mhe747/BeagleSDR2/photo/IMG_20190711_085238.jpg

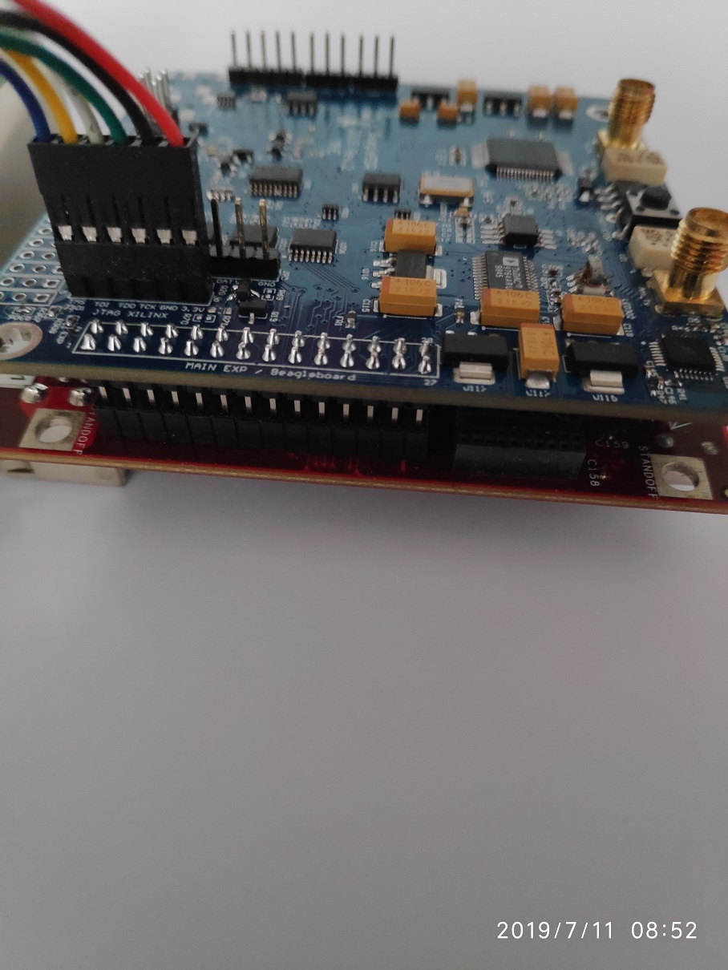
photo/IMG_20190711_085238.jpg
