mhe747/BeagleSDR2/photo/IMG_20190711_085028.jpg

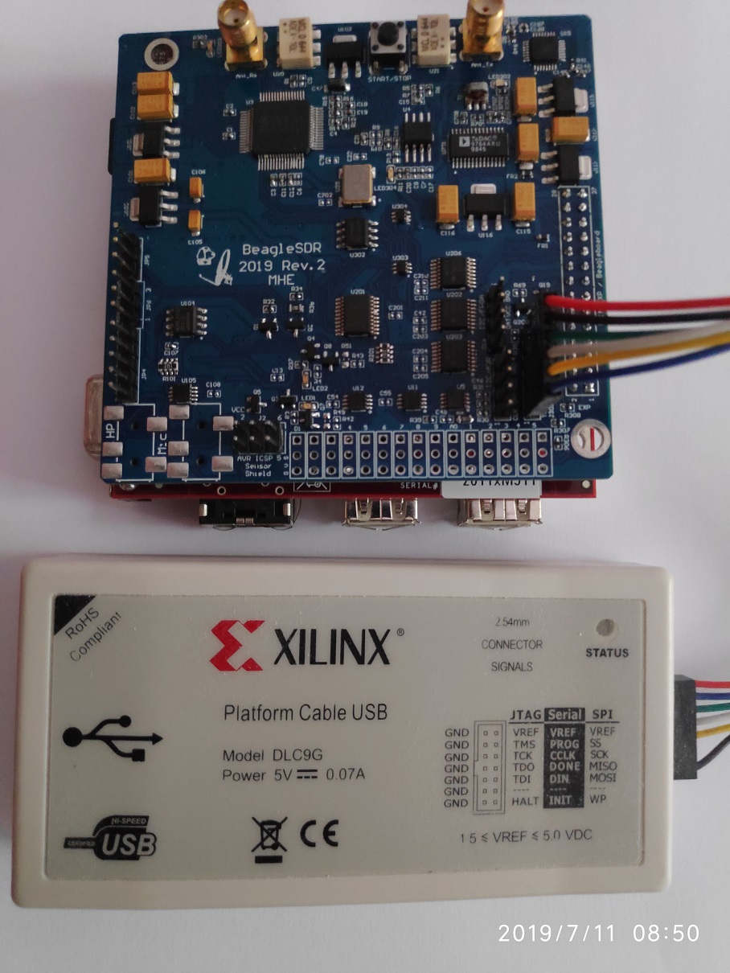
photo/IMG_20190711_085028.jpg
