mhe747/BeagleSDR2/photo/Readme.md

Some photos of the BeagleSDR2, the add-on board for the famous beagleboard-xM
