mhe747/BeagleSDR2/MHE.jpg

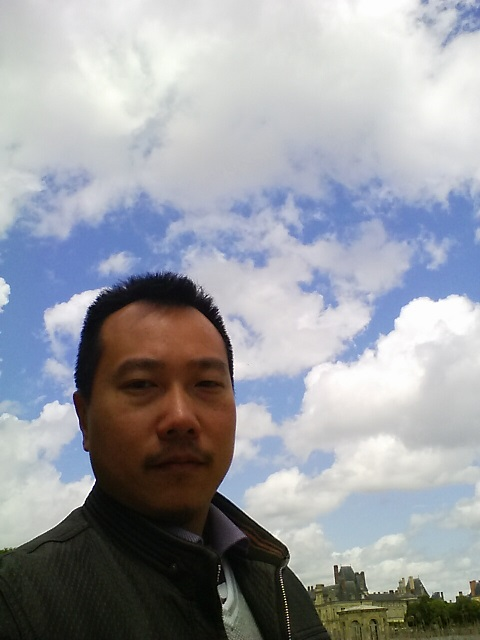
MHE.jpg
