mhe747/BeagleSDR2/photo/IMG_20190711_004727.jpg

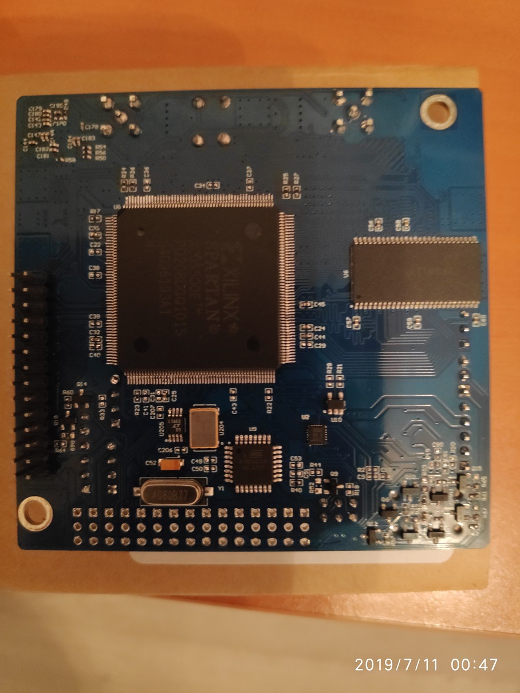
photo/IMG_20190711_004727.jpg
