mhe747/BeagleSDR2/photo/IMG_20190711_090203.jpg

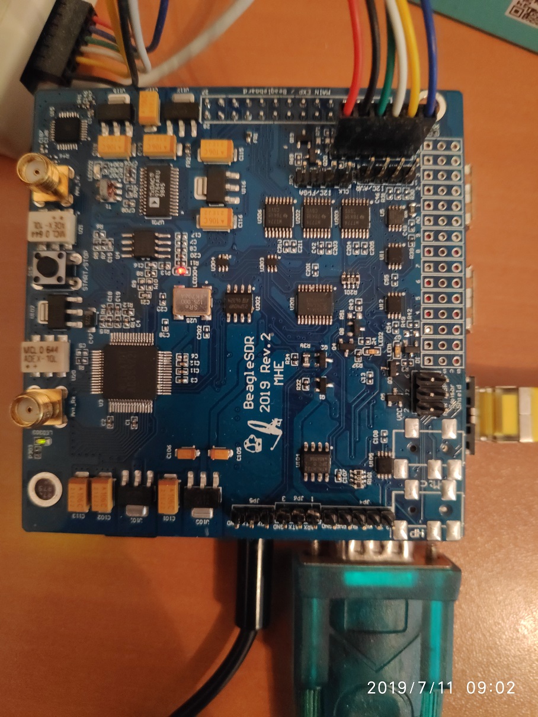
photo/IMG_20190711_090203.jpg
