mhe747/BeagleSDR2/schematics/beagle_sdr2_overlay_bottom.png

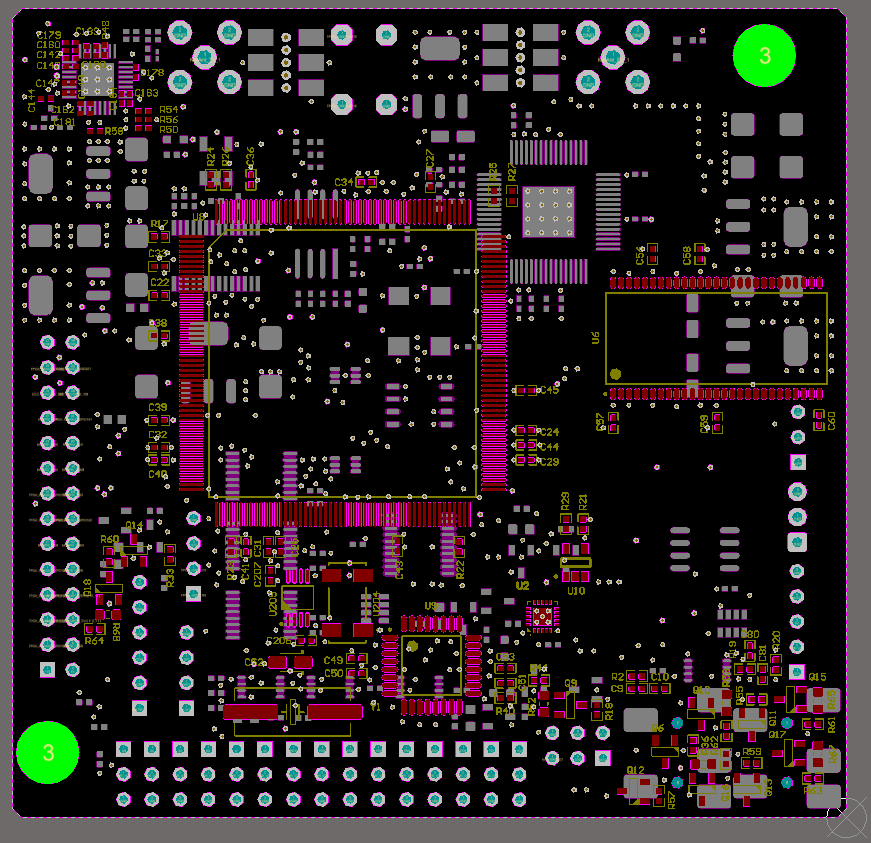
schematics/beagle_sdr2_overlay_bottom.png
