mhe747/BeagleSDR2/schematics/beagle_sdr2_pcb_bottom.png

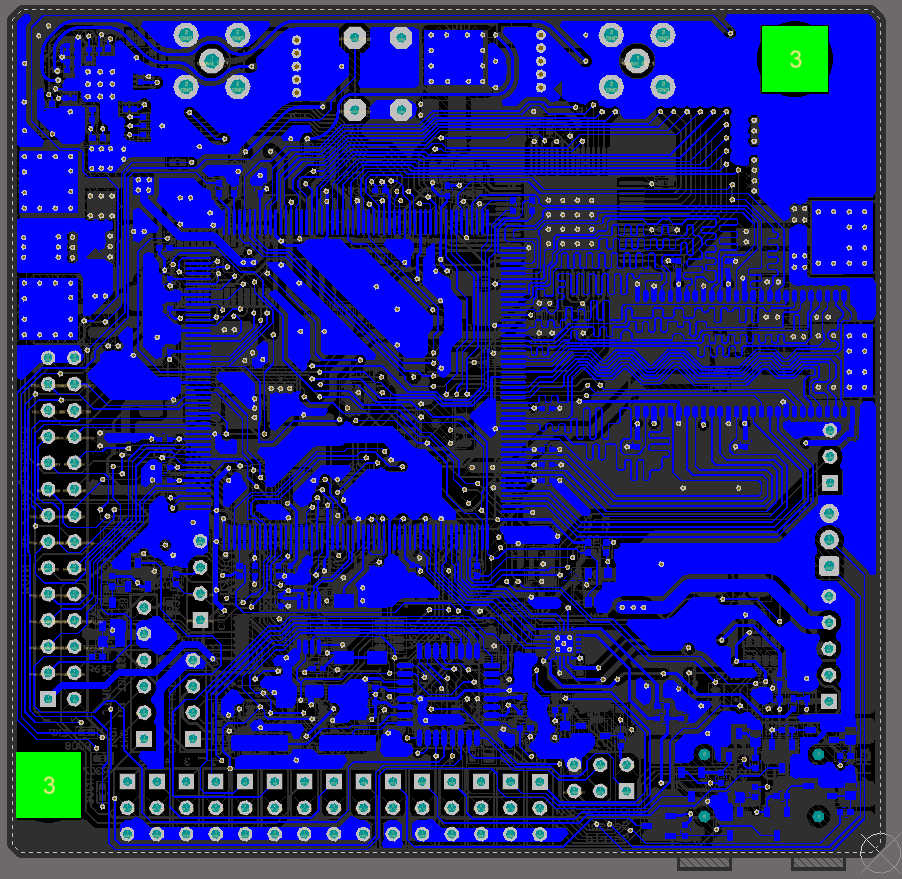
schematics/beagle_sdr2_pcb_bottom.png
