mhe747/BeagleSDR2/schematics/beagle_sdr2_pcb_top.png

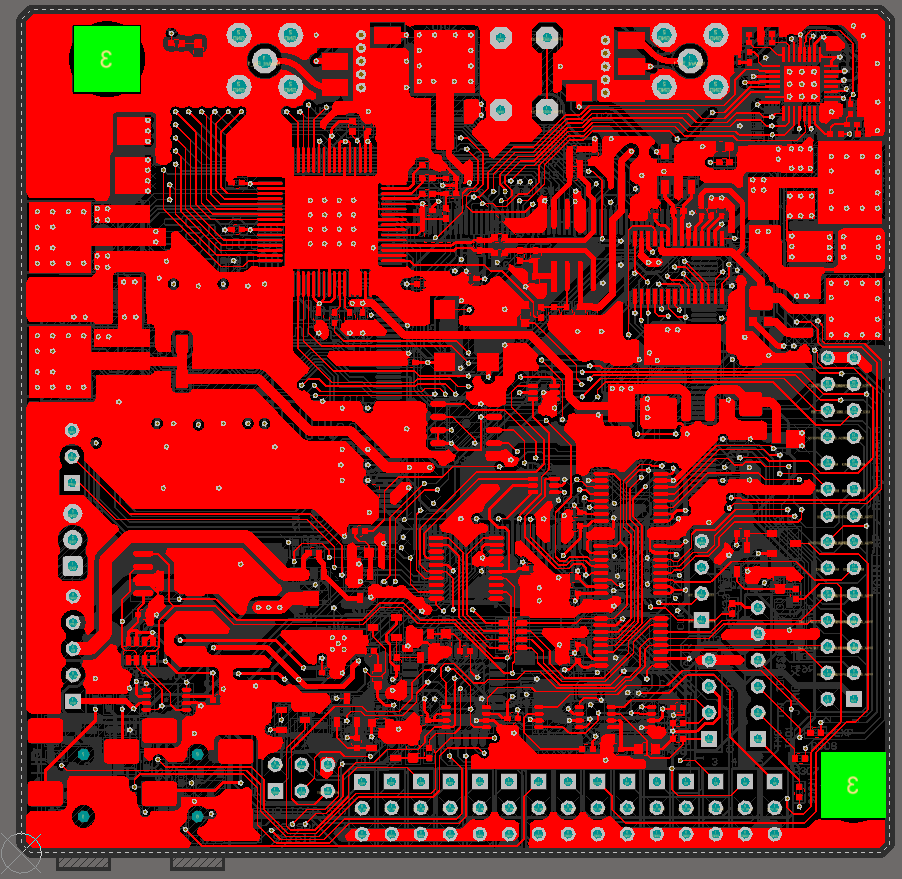
schematics/beagle_sdr2_pcb_top.png
