mhe747/BeagleSDR2/schematics/beagle_sdr2.pdf

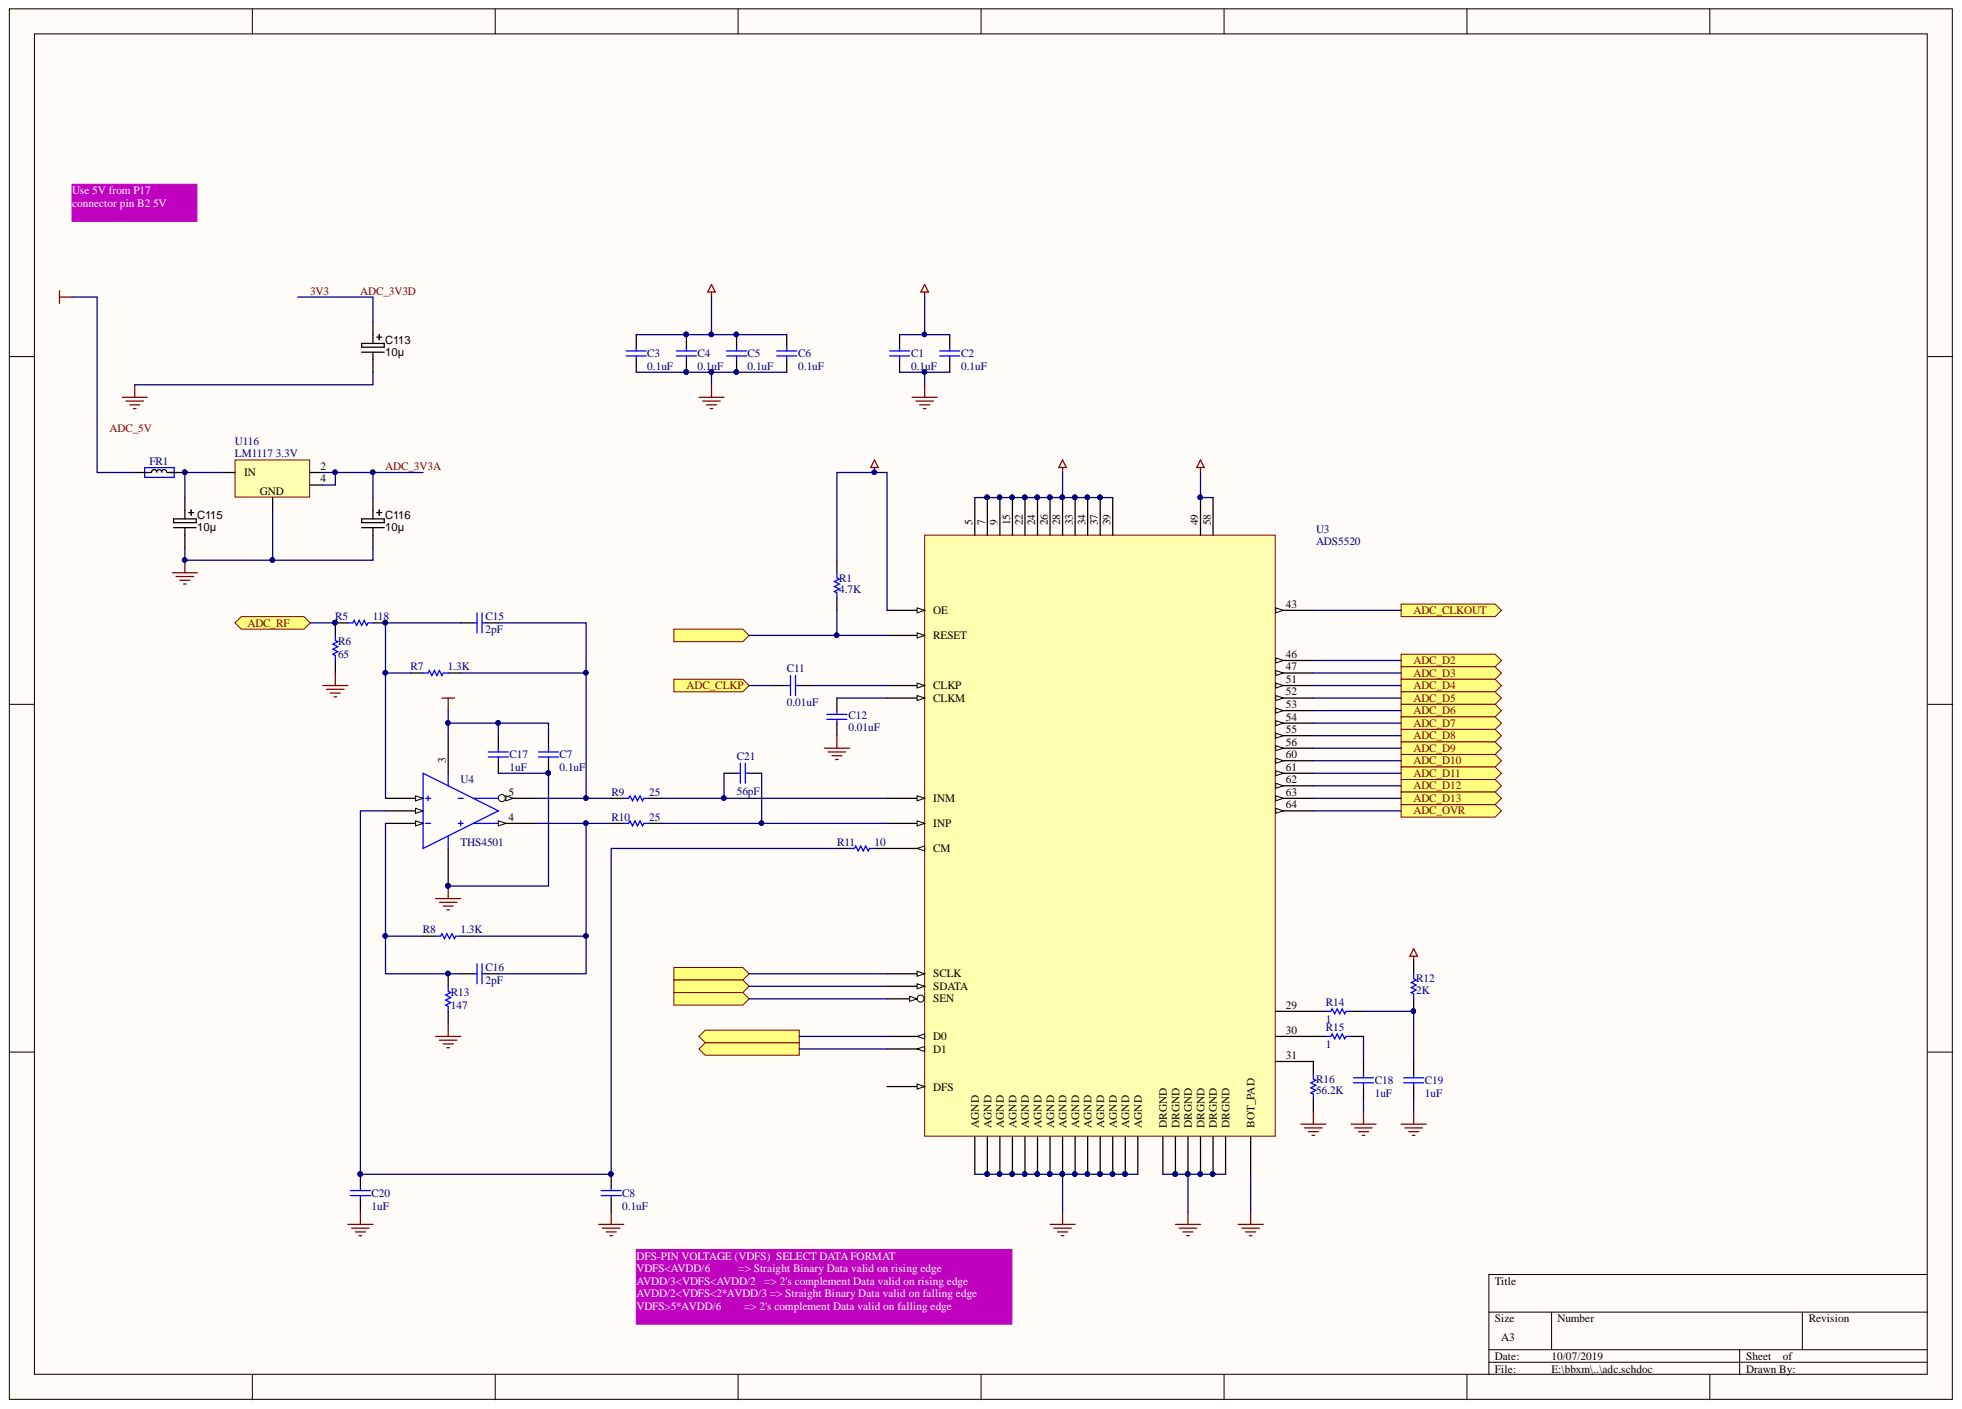
[picture p10: page 1]

THS4501 | 4

DFS-PIN VOLTAGE (VDFS) SELECT DATA FORMAT
AVDD/3<VDFS<AVDD/2 => 2's complement Data valid on rising edge
AVDD/2<VDFS<2*AVDD/3 => Straight Binary Data valid on falling edge

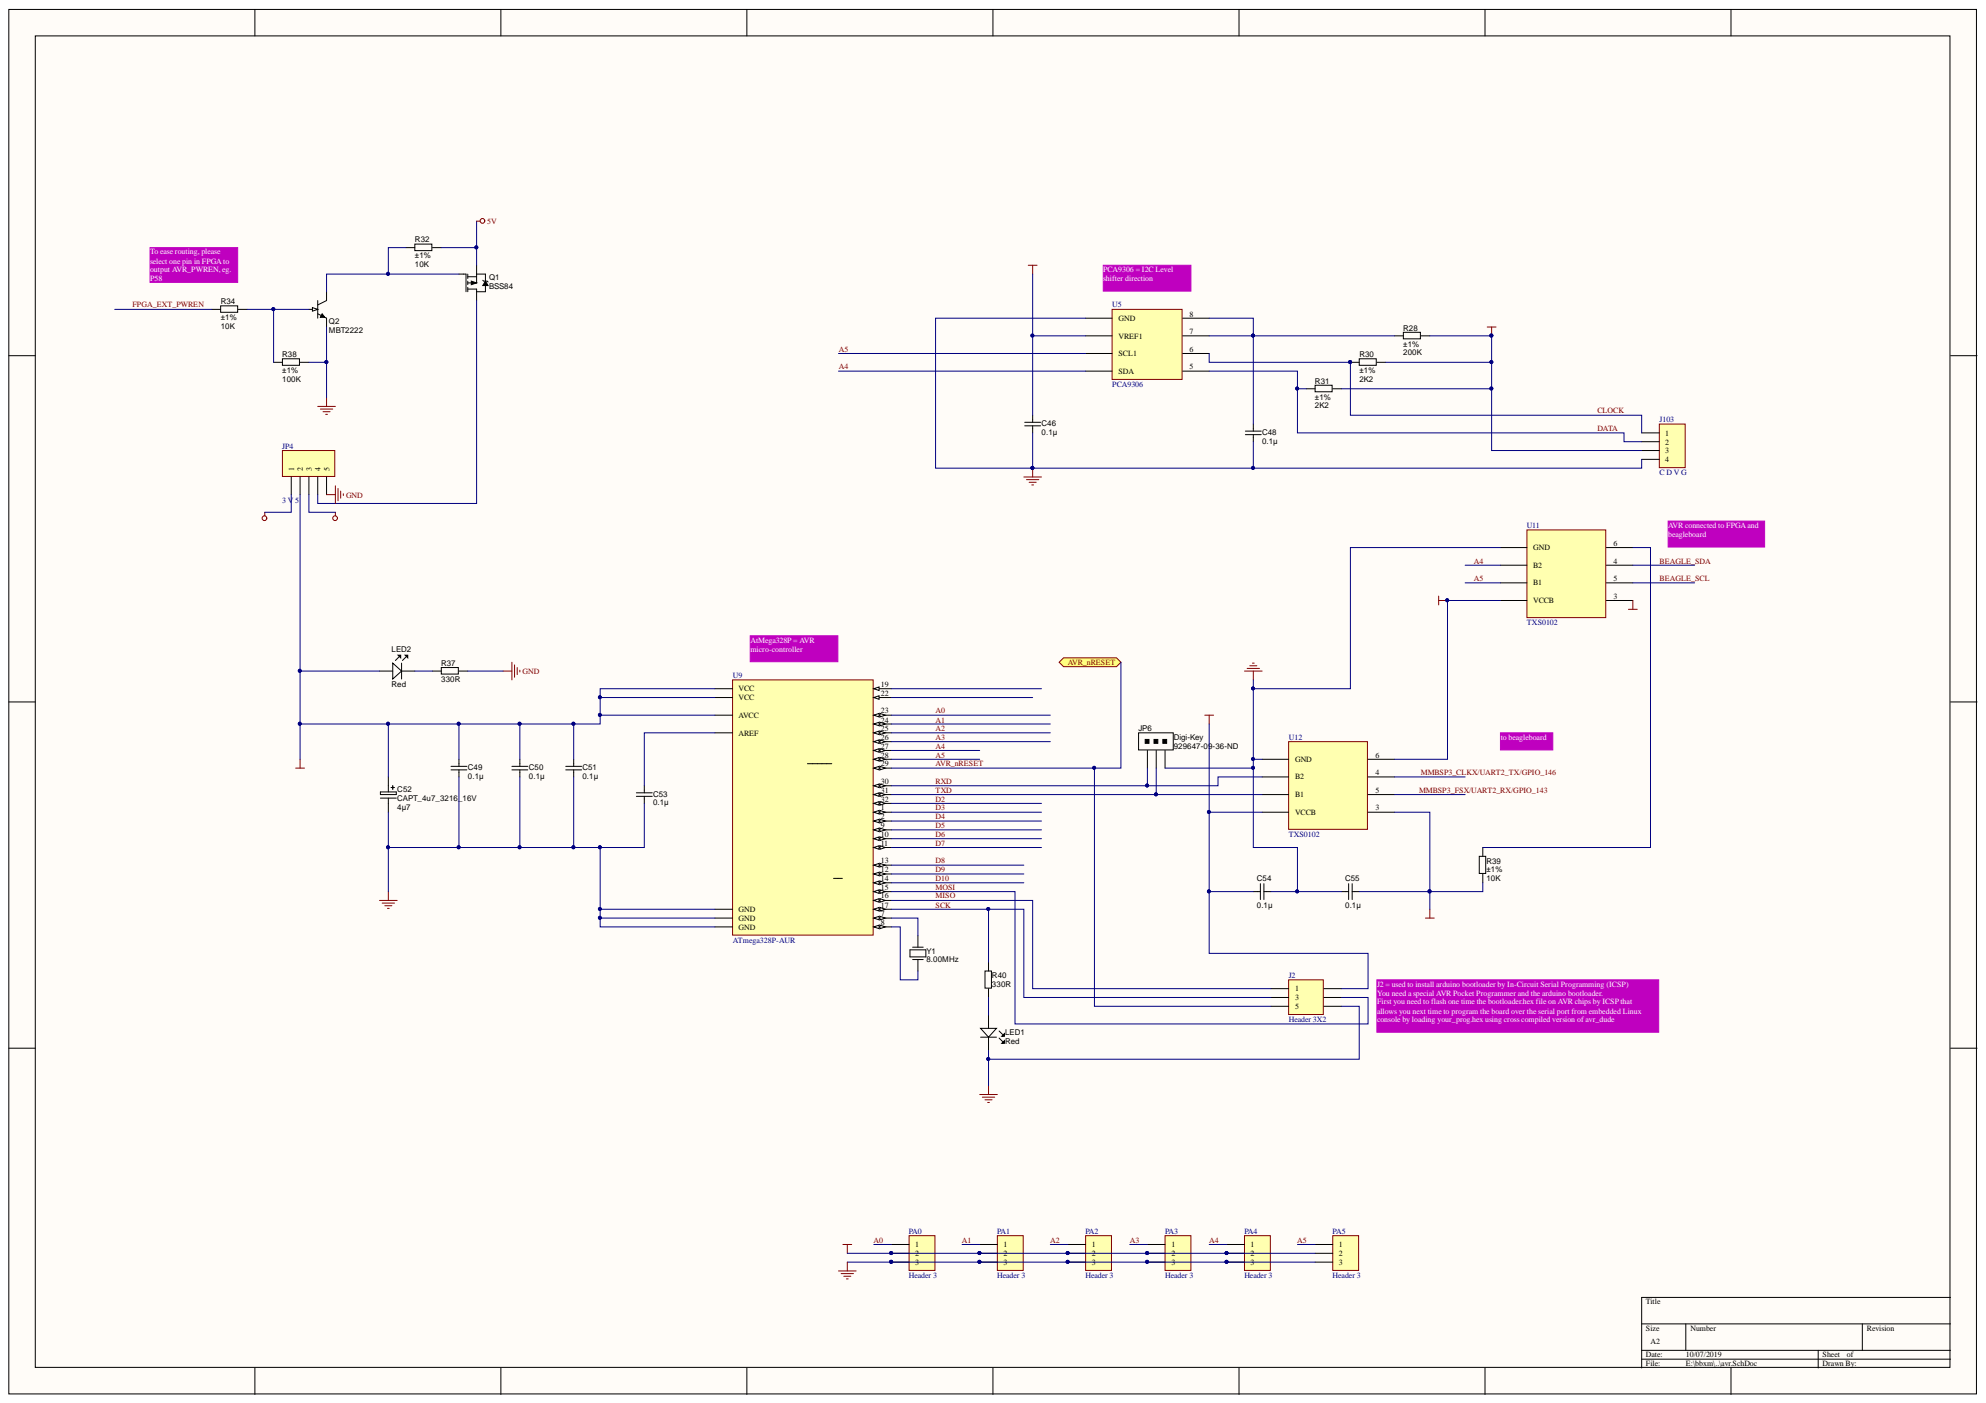
[picture p11: page 2]

To ease routing, please
select one pin in FPGA to
output AVR_PWREN, eg.

AVR connected to FPGA and
beagleboard

SCK | 0.1µ

J2 = used to install arduino bootloader by In-Circuit Serial Programming (ICSP)
You need a special AVR Pocket Programmer and the arduino bootloader.
First you need to flash one time the bootloader.hex file on AVR chips by ICSP that
allows you next time to program the board over the serial port from embedded Linux
console by loading your_prog.hex using cross compiled version of avr_dude

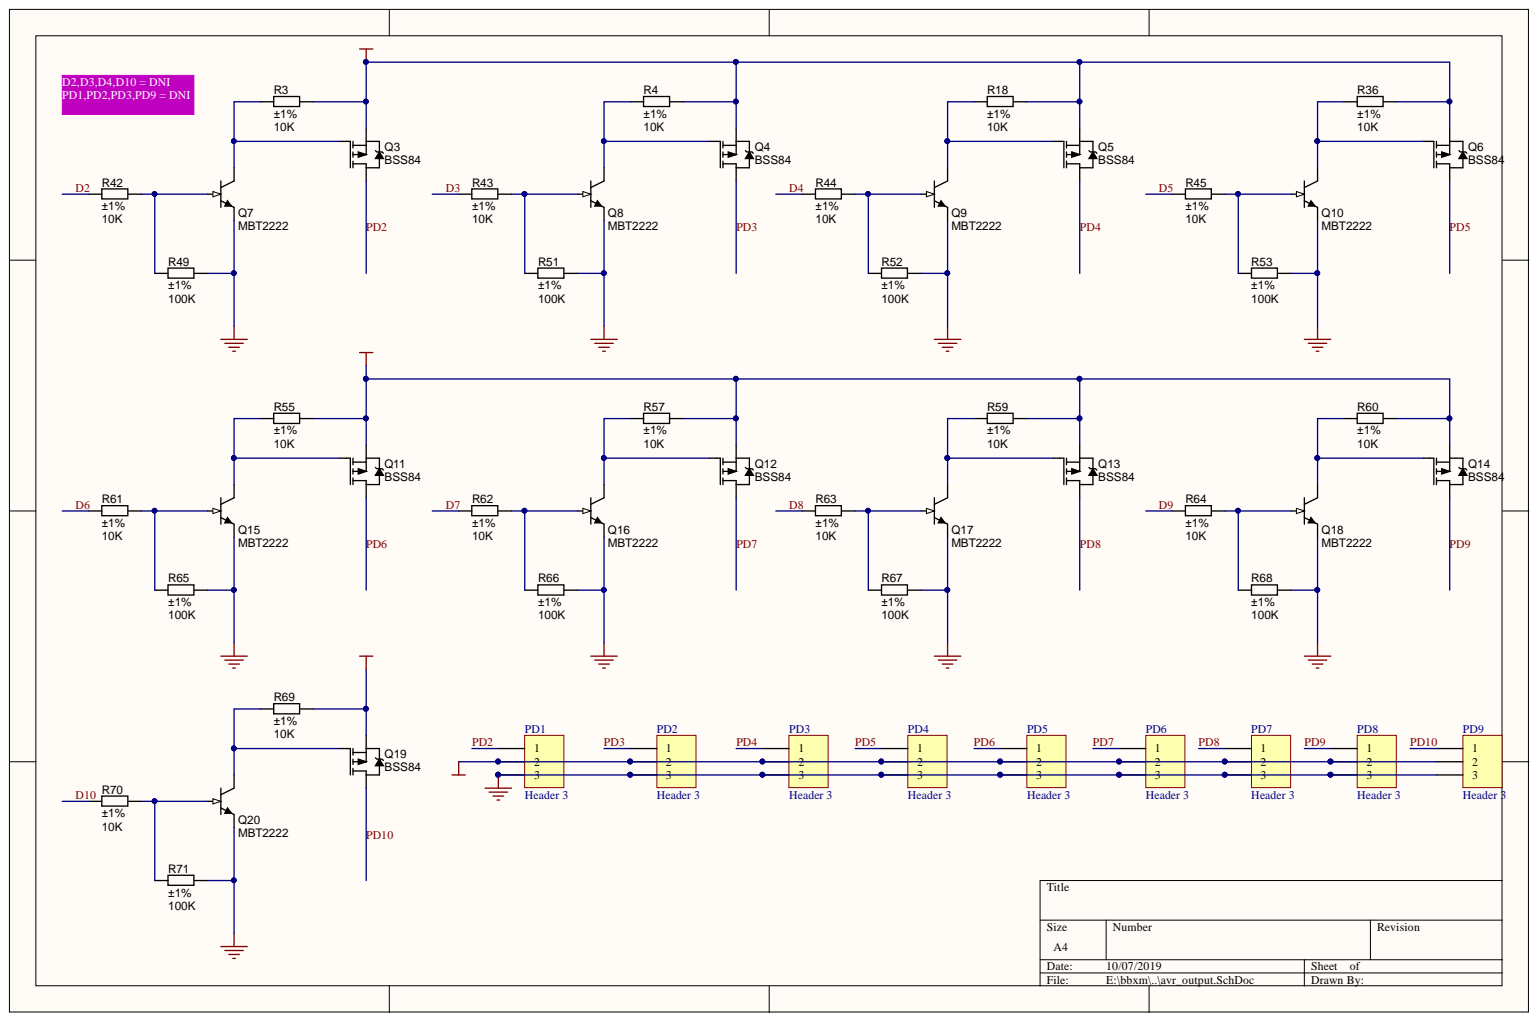
[picture p12: page 3]

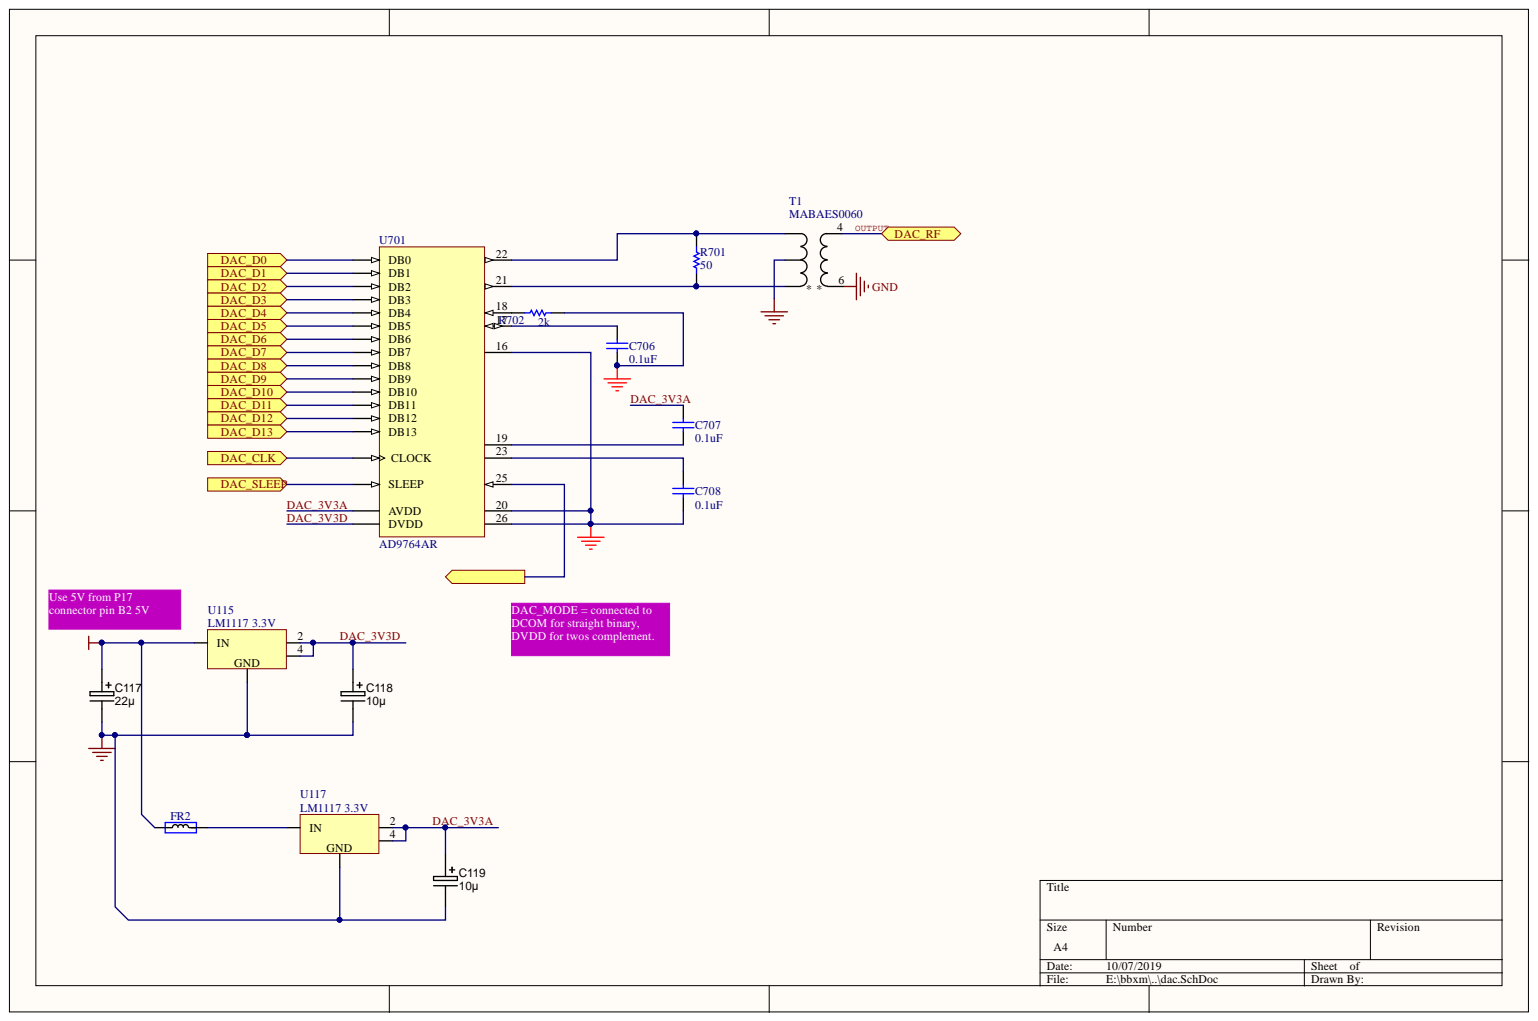
[picture p13: page 4]

DAC_MODE = connected to
DCOM for straight binary,
DVDD for twos complement.

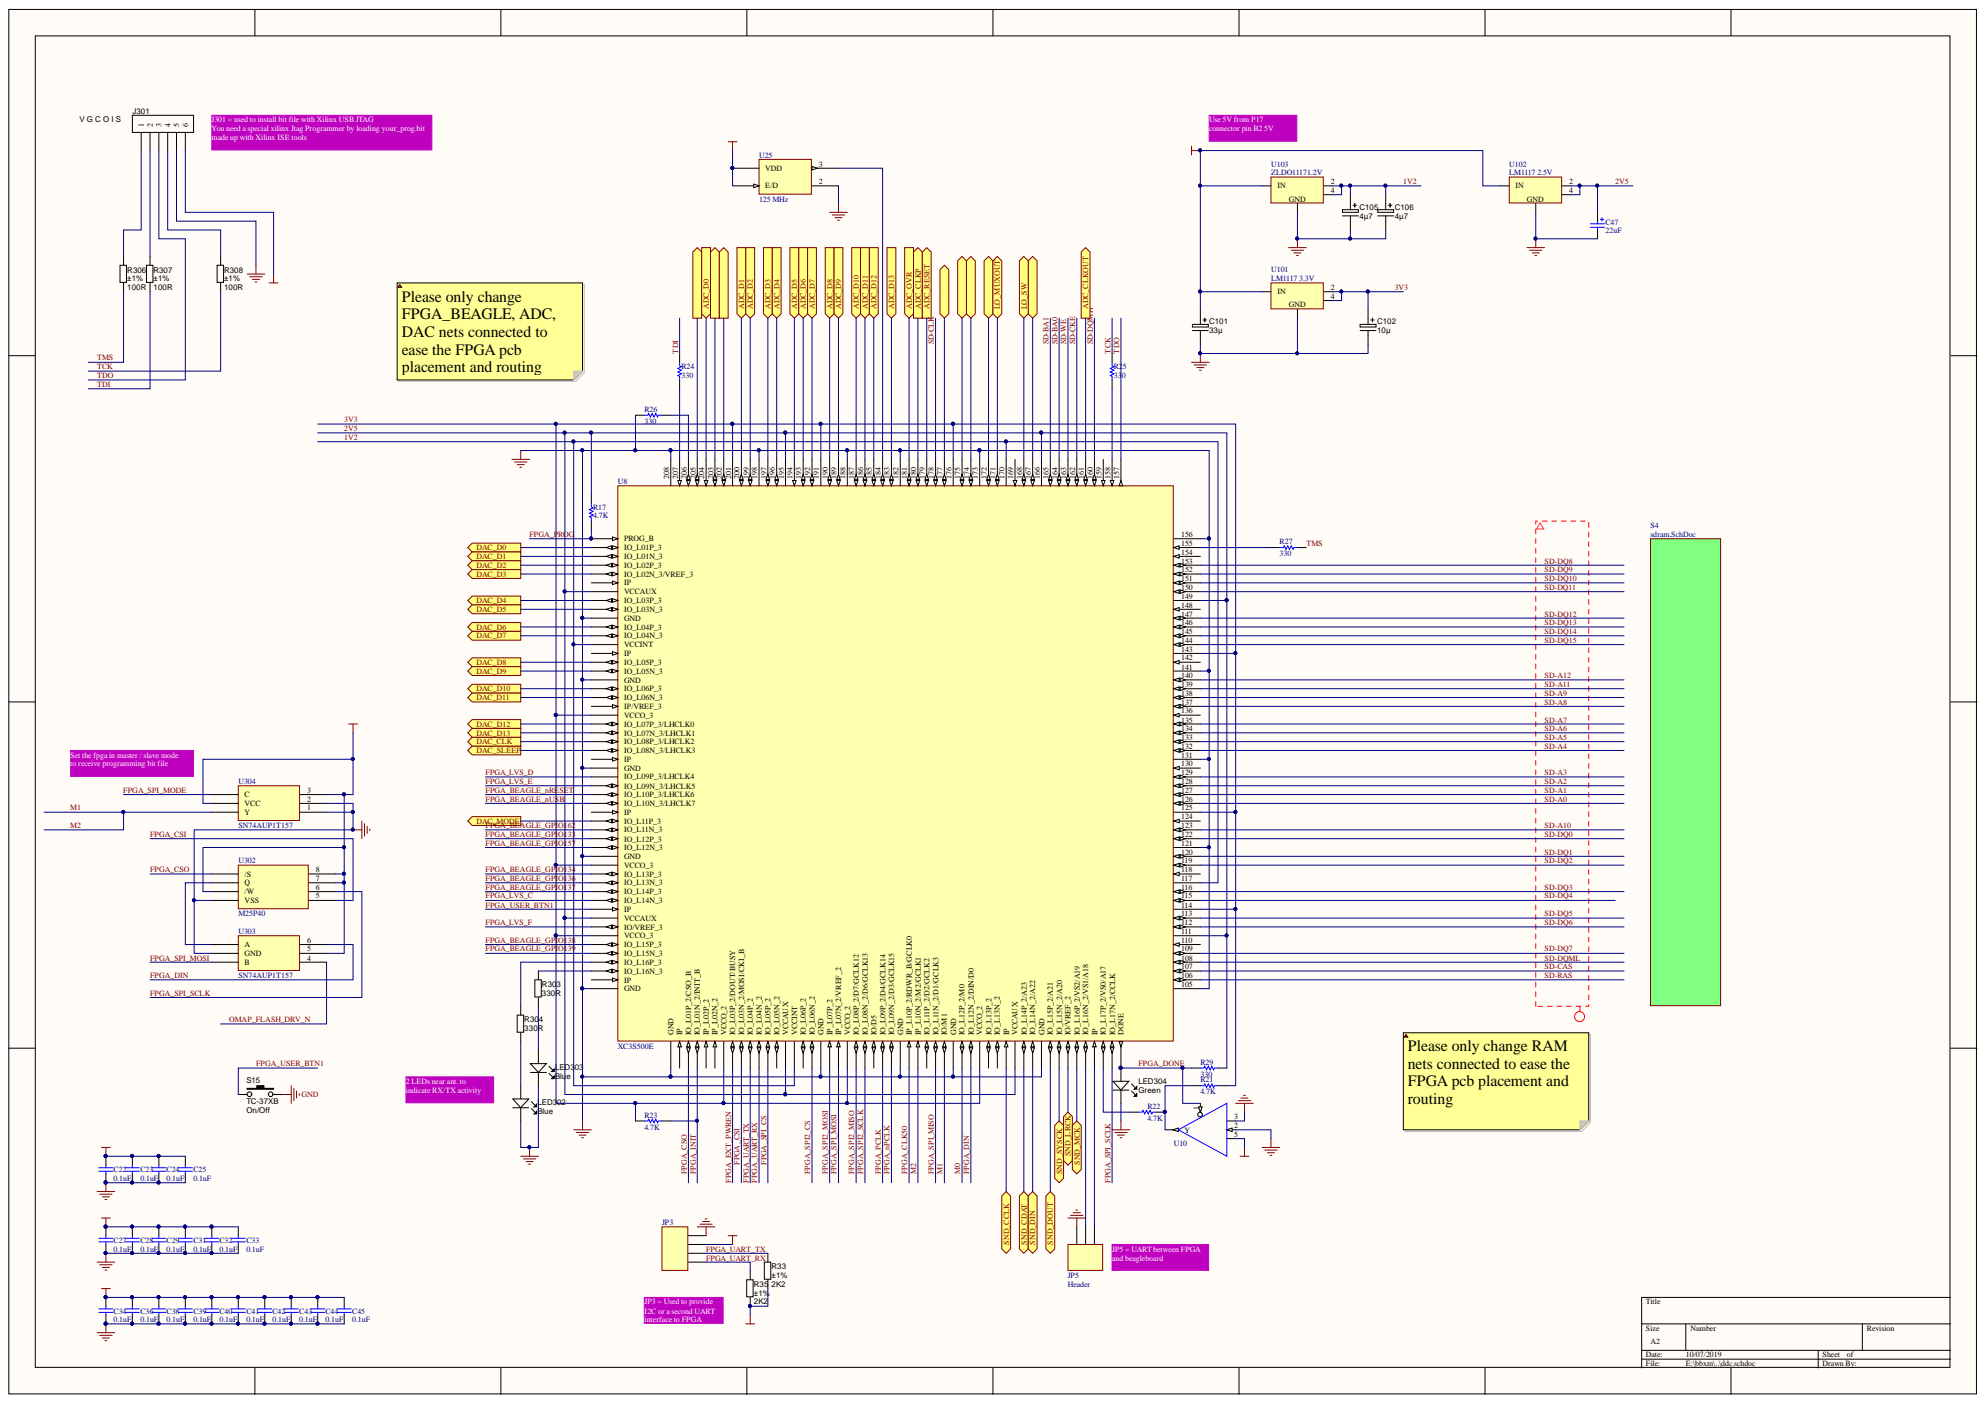
[picture p14: page 5]

J301 = used to install bit file with Xilinx USB JTAG
You need a special xilinx Jtag Programmer by loading your_prog.bit
made up with Xilinx ISE tools

Please only change
FPGA_BEAGLE, ADC,
DAC nets connected to
ease the FPGA pcb
placement and routing

IO_L03P_0 164 IO_L03N_0 165 VCCAUX 166 IO_L04P_0 167 IO_L04N_0/VREF_0 168 IP 169 VCCINT 170 IO_L05P_0 171 IO_L05N_0 172 GND 173 IO_L06P_0 174 IO_L06N_0 175 VCCO_0 176 IO_L07P_0/GCLK4 177 IO_L07N_0/GCLK5 178 IO/VREF_0 179 IO_L08P_0/GCLK6 180 IO_L08N_0/GCLK7 181 GND 182 IO_L09P_0/GCLK8 183 IO_L09N_0/GCLK9 184 IO_L10P_0/GCLK10 185 IO_L10N_0/GCLK11 186 IO 187 GND 188 IO_L11P_0 189 IO_L11N_0 190 VCCO_0 191 IO_L12P_0 192 IO_L12N_0/VREF_0 193 IP 194 VCCAUX 195 IO_L13P_0 196 IO_L13N_1 197 GND 198 IO_L14P_0 199 IO_L14N_0/VREF_0 200 VCCO_0 201 IO_L15P_0 202 IO_L15N_0 203 IP 204 IO_L16P_0 205 IO_L16N_0/HSWAP 206 TDI 207 GND 208

Set the fpga in master / slave mode
to receive programming bit file

FPGA_SPI_MOSI

FPGA_DIN

FPGA_SPI_SCLK

Please only change RAM
nets connected to ease the
FPGA pcb placement and
routing

2 LEDs near ant. to
indicate RX/TX activity

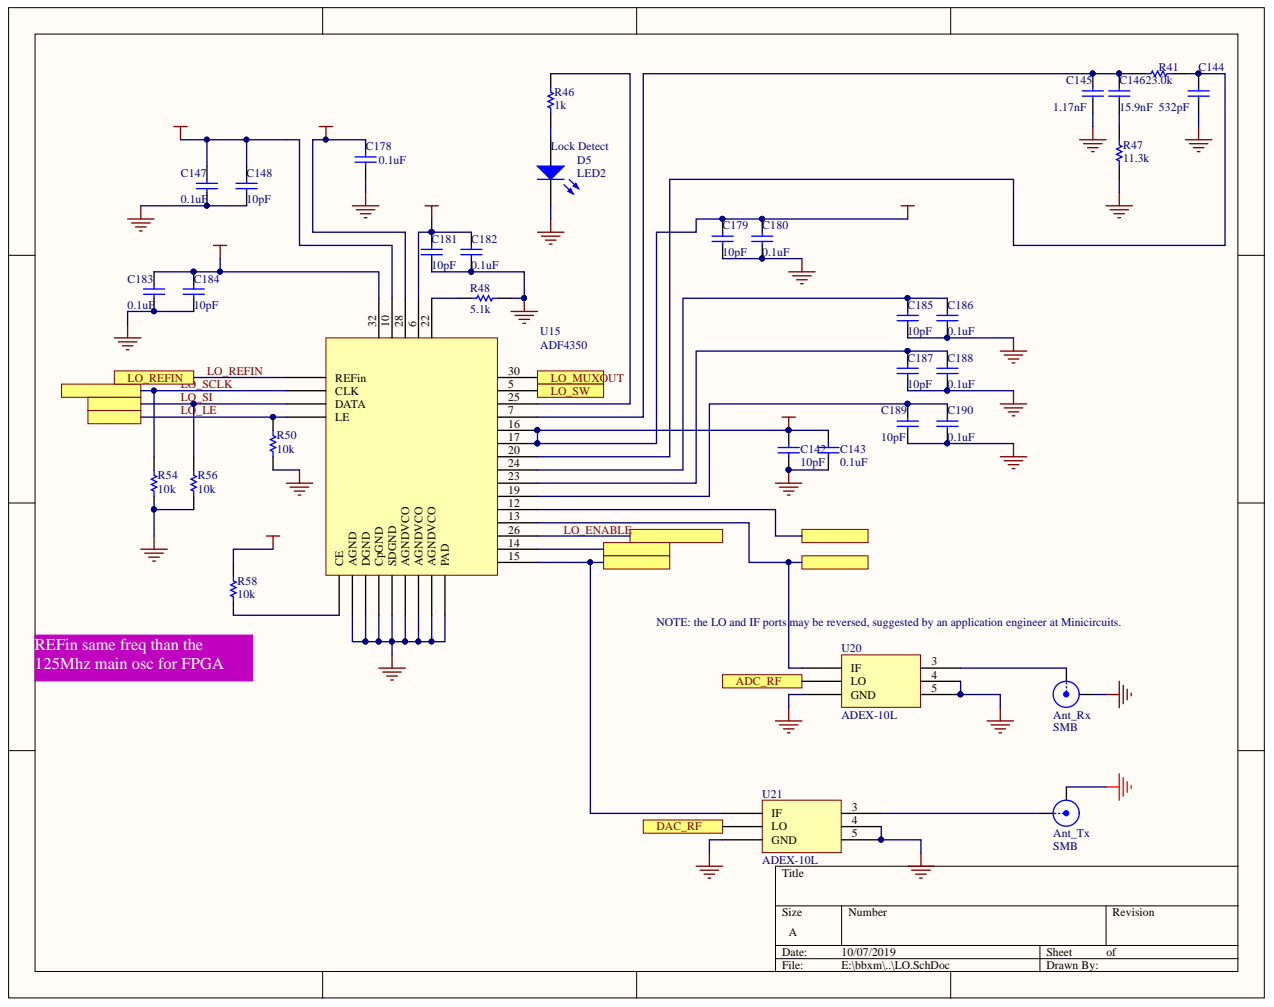
[picture p15: page 6]

U15 ADF4350

NOTE: the LO and IF ports may be reversed, suggested by an application engineer at Minicircuits.

REFin same freq than the
125Mhz main osc for FPGA

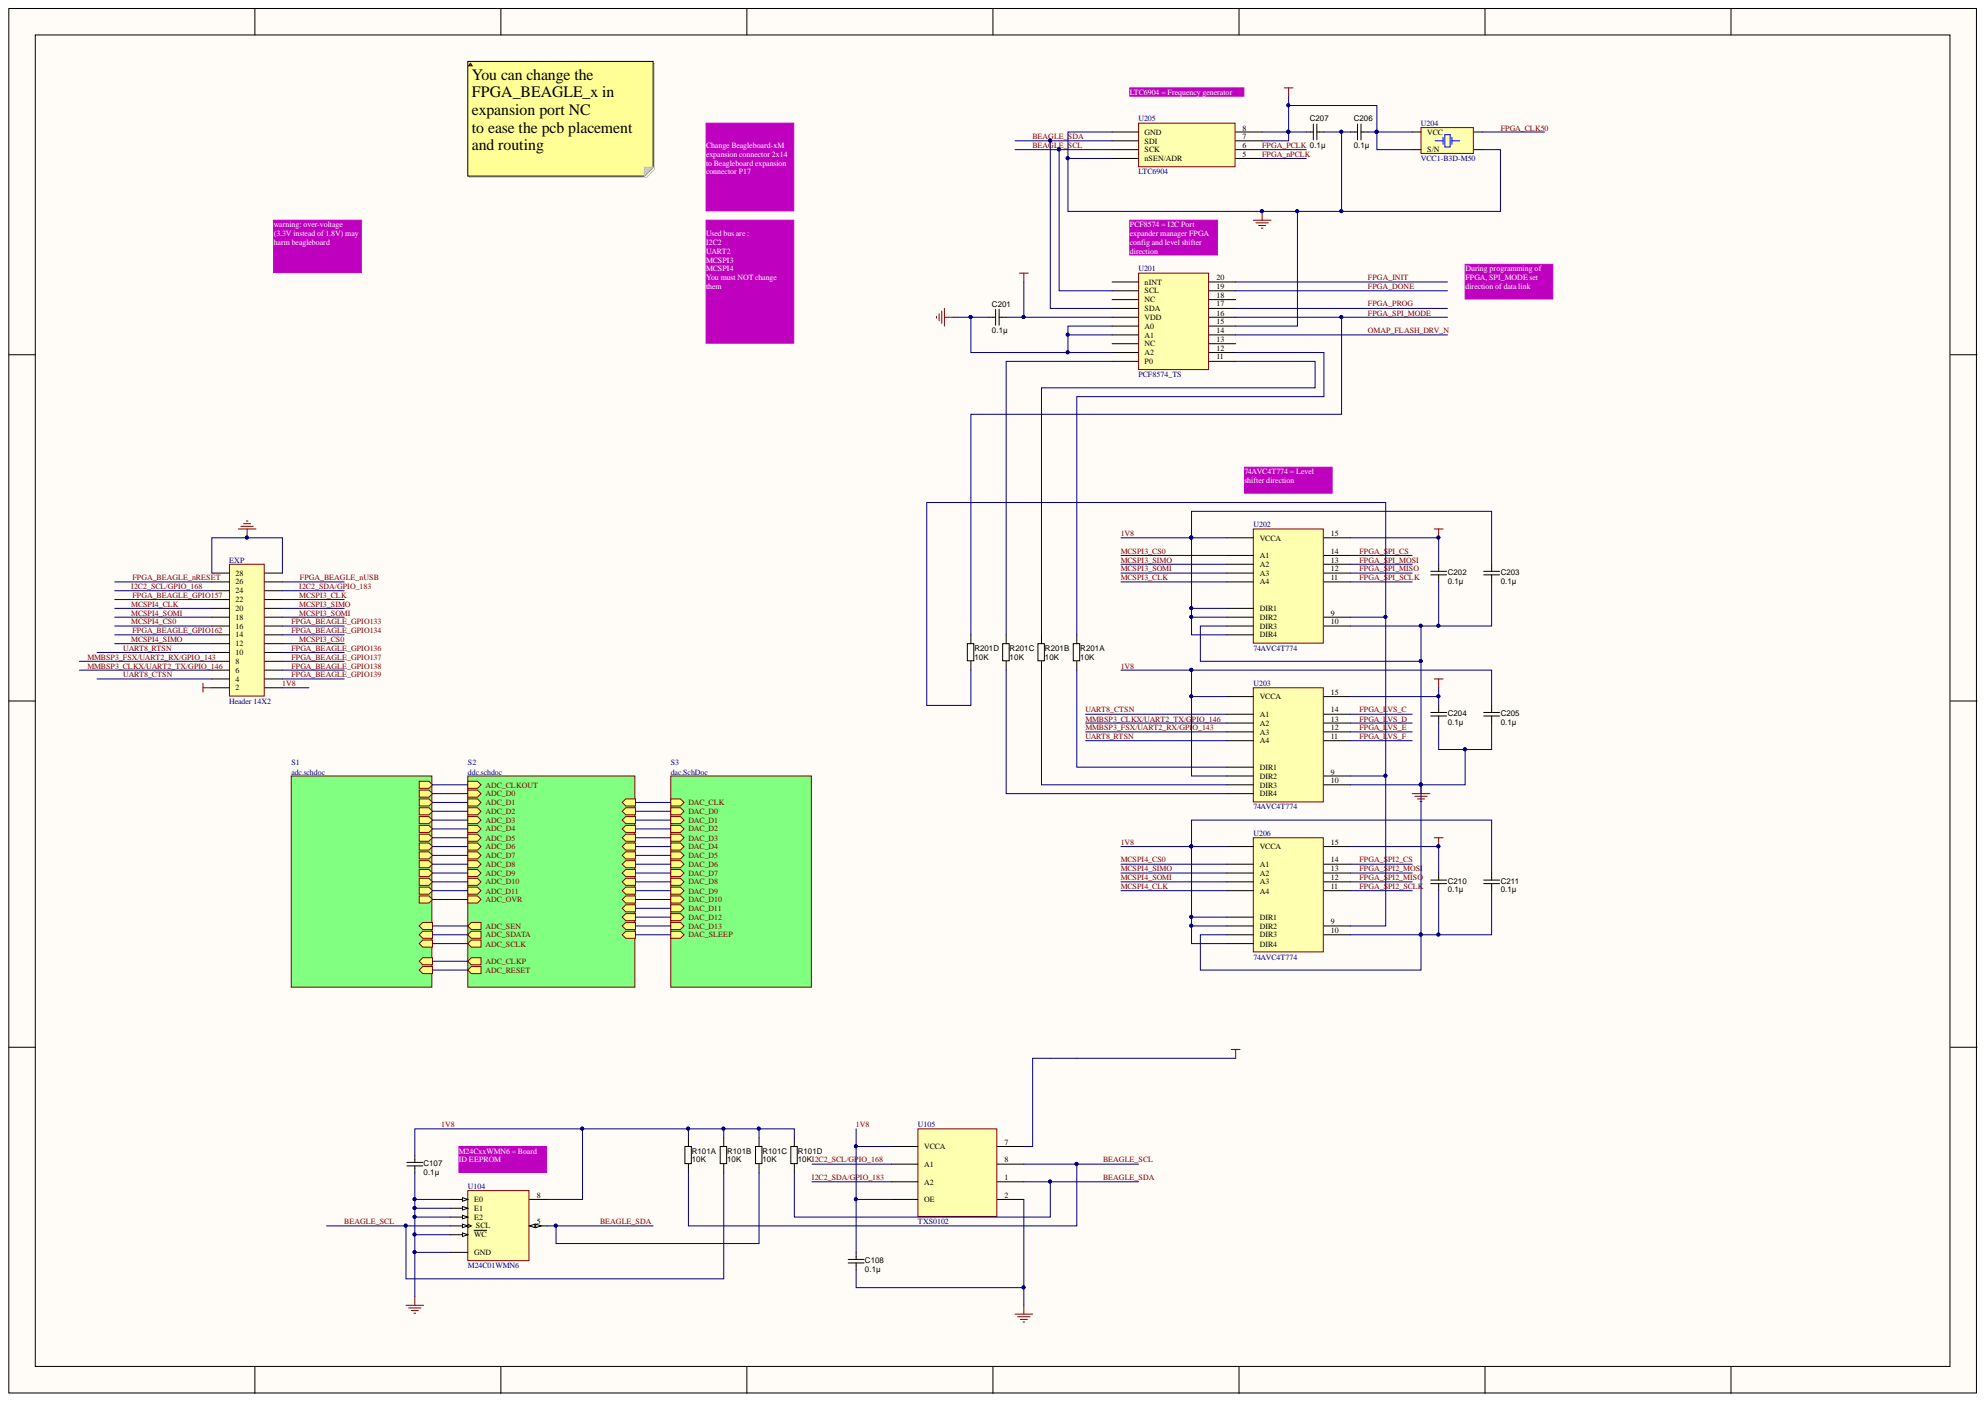
[picture p16: page 7]

You can change the
FPGA_BEAGLE_x in
expansion port NC
to ease the pcb placement
and routing

FPGA_nPCLK | VCC1-B3D-M50

PCF8574 = I2C Port
expander manager FPGA
config and level shifter
direction

During programming of
FPGA, SPI_MODE set
direction of data link

FPGA_DONE

UART8_CTSN | | U203

FPGA_SPI2_CS
FPGA_SPI2_MOSI FPGA_SPI2_MISO

FPGA_SPI2_SCLK

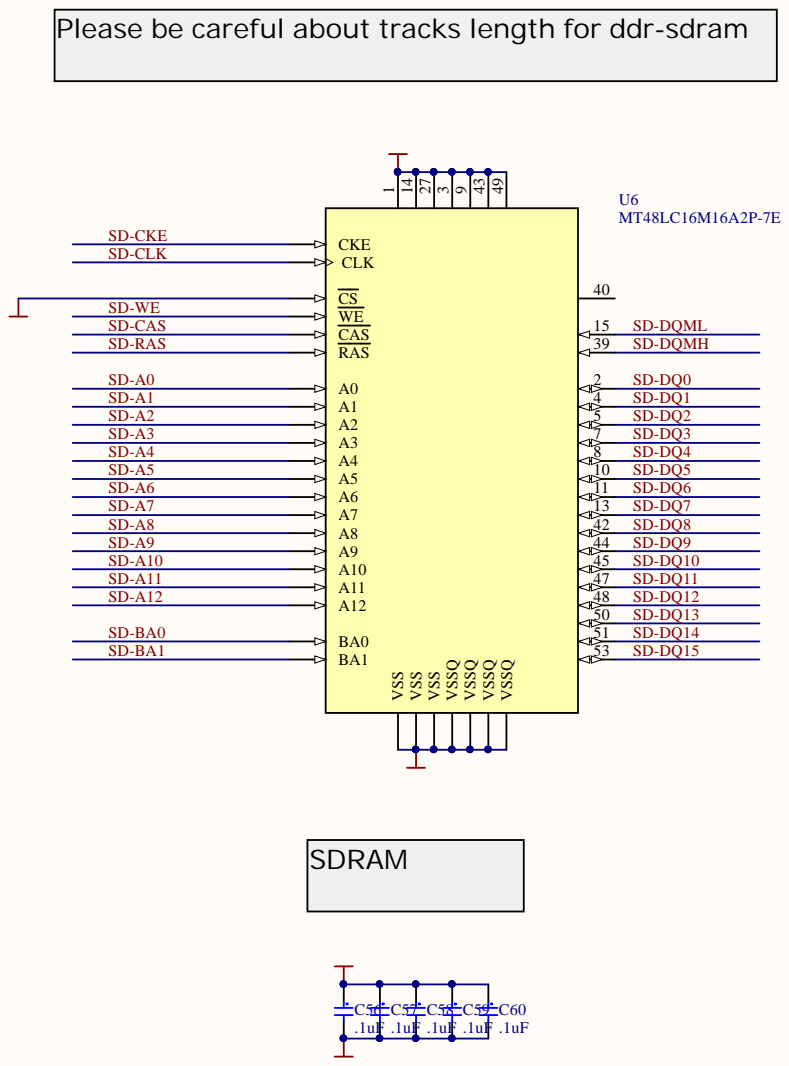
[picture p17: page 8]

Please be careful about tracks length for ddr-sdram

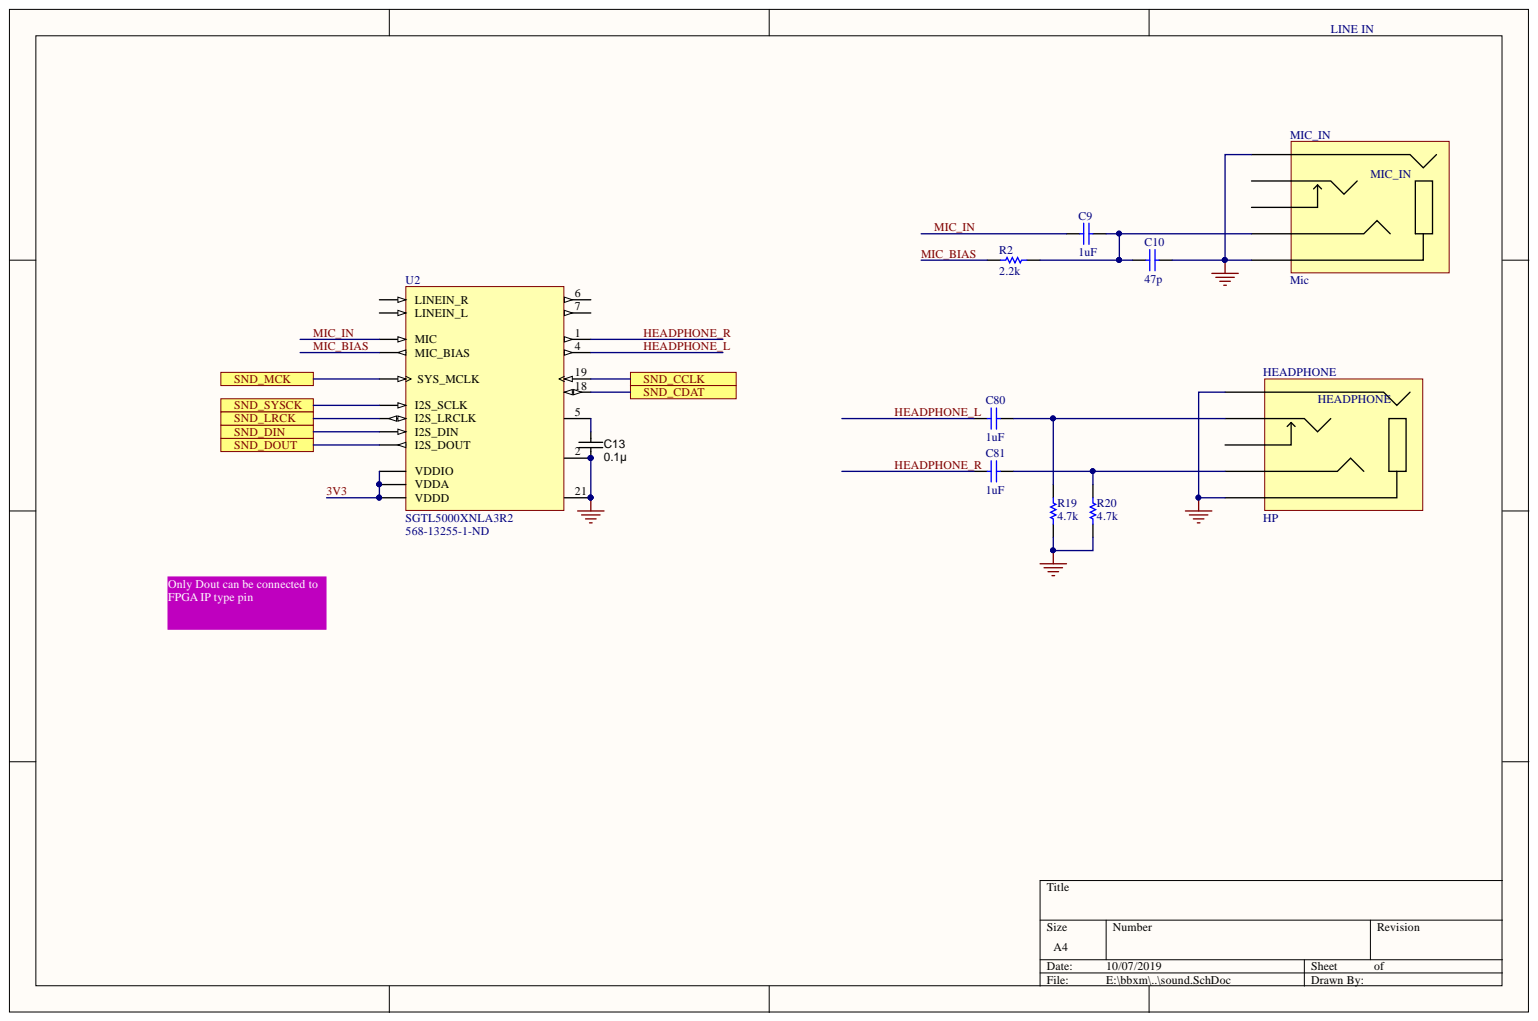
[picture p18: page 9]

HEADPHONE

Only Dout can be connected to
FPGA IP type pin

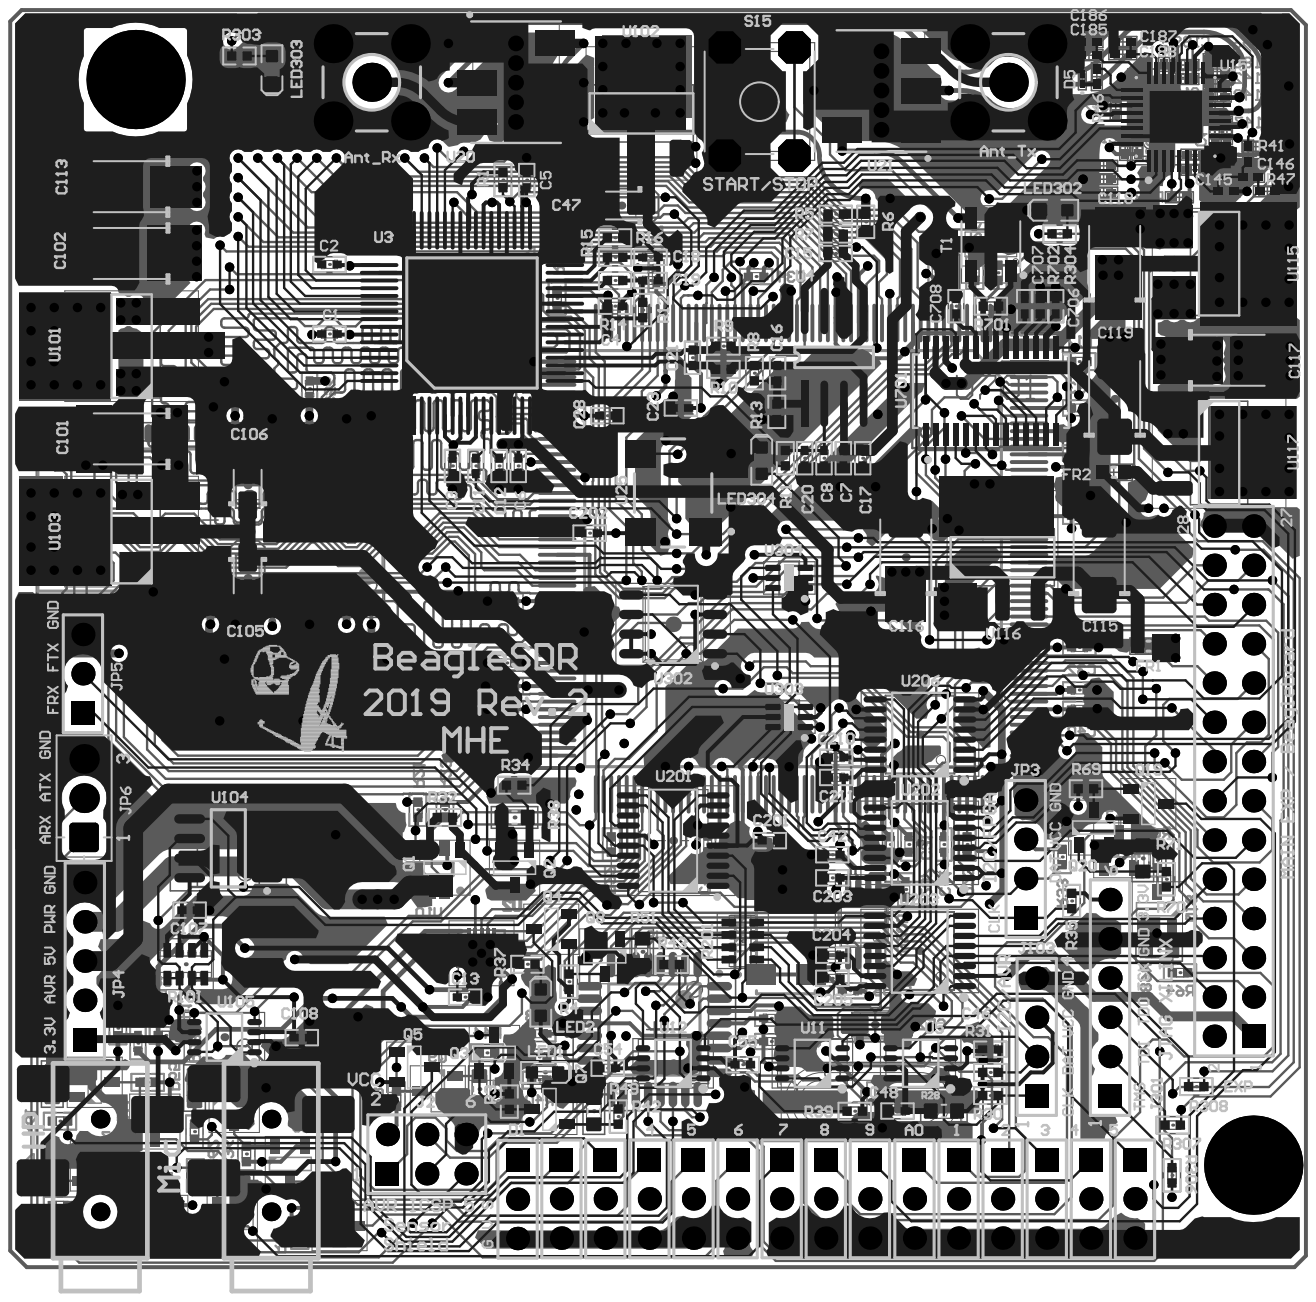
[picture p19: page 10]
