mhe747/BeagleSDR2/(commit log)

2019-07-10 upload schematics
2019-07-10 pcb images
